Dalexm77/PowerAmp_OM2.7/Board/11882884293.webp

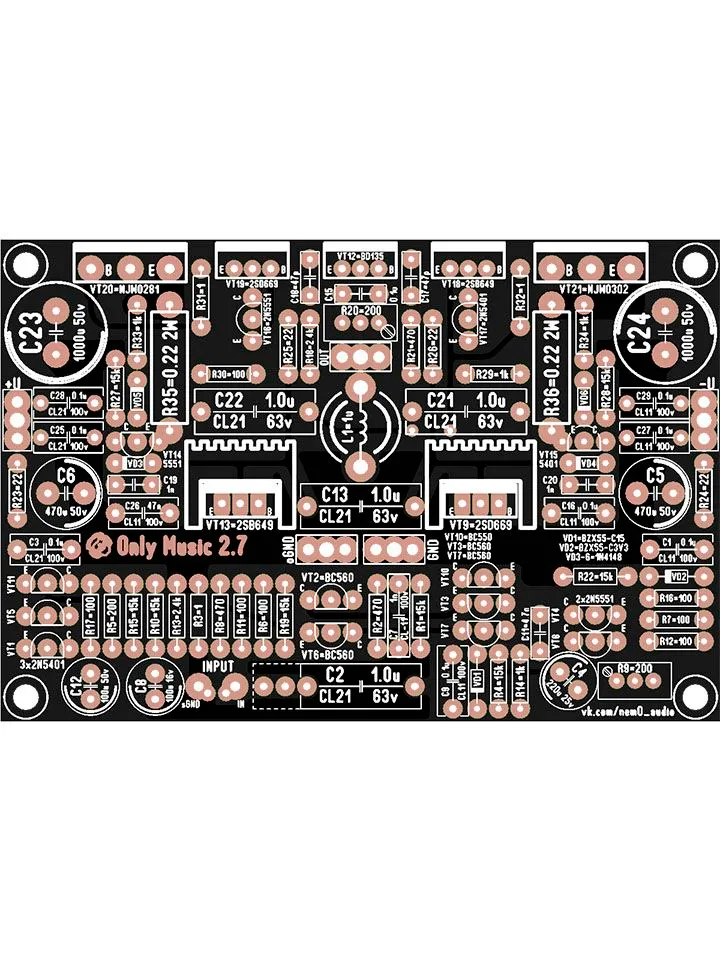
Board/11882884293.webp
