Dalexm77/PowerAmp_OM2.7/README.md

# PowerAmp_OM2.7
Power amplifier based on OM2.7 by Nem0

Элементная база:

Предпочтительно использовать металлопленочные резисторы (MF), и отказаться от использования углеродистых резисторов (CF), по причине их высокого собственного шума;

При использовании резисторов с допуском 5%, желательно осуществить подбор резисторов R6 и R11, R7 и R12, в пары, с точностью не хуже 1%;

Для достижения равного коэффициента усиления и соответственно - равной громкости обоих каналов стерео усилителя, рекомендуется заранее подобрать по две пары резисторов 15 кОм и 470 Ом (для левого и правого каналов усилителя), с точностью не хуже 1%, для использования их в качестве - R1 и R19, R2 и R8;

При использовании резисторов с допуском 1%, осуществлять подбор резистор - нет необходимости;

Использование в качестве R35 и R36 проволочных резисторов - не рекомендуется;

В качестве подстроечных резисторов R9 и R20, допускается использовать только многооборотные резисторы типа 3296W. Допускается использовать подстроечные резисторы с сопротивлением от 200 до 470 Ом;

При установке на плату, движок подстроечного резистора R9 должен находится в среднем положении (сопротивление между каждым из крайних и центральным выводов должно быть одинаковым), а сопротивление подстроечного резистора R20 должно максимальным;

Все типы применяемых в схеме конденсаторов и их минимально необходимое рабочее напряжение указаны в списке радиоэлементов к данной статье;
Типы конденсаторов

Не стоит переплачивать за конденсаторы аудиофильских серий - применение их в схеме усилителя не приведет к каким-либо улучшениям технических характеристик усилителя;

Допускается использование стабилитронов других моделей, но с тем же номинальным напряжением стабилизации и рассеиваемой мощностью;

Допускается использовать только те модели транзисторов, которые указаны в схеме, либо их аналоги указанные в списке радиоэлементов к данной статье;

Перед установкой каждого их транзисторов на плату, необходимо убедиться в их работоспособности, оригинальности и соответствии параметрам, указанным в даташите на данную модель транзистора;

Транзисторы VT18, VT19, VT20, VT21 и VT12, должны быть установлены на общем радиаторе. Очень приблизительно, площадь радиатора, необходимую для эффективного отвода тепла от усилителя, можно выбрать из расчета 10-15 см2 на каждый Ватт выходной мощности усилителя (1000-1500см2 для одного канала усилителя с выходной мощностью 100 Вт);

Транзисторы VT9 и VT13, могут быть установлены на небольшие теплоотводы (для этого предусмотрены места на печатных платах), однако допускается эксплуатация усилителя без установки транзисторов VT9 и VT13 на радиаторы;

Транзисторы VT2 и VT6, VT3 и VT7, VT4 и VT8, необходимо подобрать в пары по коэффициенту усиления с точностью не хуже 1%;

Выводы на печатной плате. 
Наименование и назначение выводов на односторонней и двухсторонней платах - идентичны, поэтому следующая информация актуальна для обоих вариантов печатных плат:

+U - плюс питания;  
-U - минус питания;  
GND - основная силовая земля;  
oGND - выходная земля (минусовая выходная клемма усилителя);  
sGND - сигнальная земля;  
IN - вход сигнала;  
OUT - выход сигнала (плюсовая выходная клемма усилителя).  

Коммутация блоков внутри усилителя. Правильный способ соединения блоков и земель внутри корпуса усилителя:  
Способ коммутации блоков внутри корпуса стерео усилителя
Эксплуатация усилителя без устройства защиты акустической системы (АС) - не безопасна и строго не рекомендуется. Работа усилителя без устройств защиту допускается только для первого запуска и настройки усилителя. В качестве защиты АС для данного усилителя рекомендую использовать устройство защиты - DEF 2017.  

Настройка усилителя.  
После успешного первого включения усилителя, необходимо произвести регулировку "ноля" и тока покоя. Для регулировки "ноля", необходимо:

1. Замкнуть вход усилителя (замкнуть выводы IN и sGND на плате усилителя);
2. Подключить милливольтметр или мультиметр к выходу усилителя (выводы OUT и oGND на плате);
3. Вращая движок подстроечного резистора R9, добиться максимально близкого к нолю значения постоянного напряжения на выходе усилителя (хорошим можно считать результат, когда постоянное напряжение на выходе усилителя не превышает +/-5 мВ).

На следующем этапе настройки, необходимо выставить какое-либо произвольное значение тока покоя, чтобы прогреть усилитель перед финальной регулировкой тока покоя. Для регулировки тока покоя, необходимо:

1. Щупы мультиметра (милливольтметра), необходимо подключить к эмитерам выходных транзисторов (VT20 и VT21), как показано на иллюстрации;
Точки подключения щупов мультиметра (миливольтметра)
2. Вращая движок подстроечного резистора R20, выставить небольшой ток покоя (примерно 40-50 мА, что соответствует показаниям подключенного к выходу милливольтметра 18 - 22 мВ);
3. Оставить усилитель поработать в таком состоянии приблизительно на десять минут.

Регулировать ток покоя без прогрева усилителя - не рекомендуется так как после прогрева усилителя, значение тока покоя изменится относительно выставленного значения на холодном усилителе.

4. Когда усилитель прогреется (температура выходных транзисторов стабилизируется на одном значении и перестанет расти), можно продолжать регулировку тока покоя;

5. Вращая движок R20, выставляем необходимое значение тока покоя.

Рекомендуется выставлять значение тока покоя в диапазоне от 70 до 100 мА (что соответствует показаниям милливольтметра подключенного к выходу усилителя - 30 - 44 мВ). Большее значение тока покоя не окажет значительного положительного влияния на технические характеристики усилителя, а превышение определенного значения тока покоя, наоборот- приведет к ухудшению технических характеристик и значительному снижению КПД усилителя.

Нагрузку к выходу усилителя для регулировки "нуля" и тока покоя, подключать - нет необходимости.
