Dalexm77/PowerAmp_OM2.7/Board/11882883940.webp

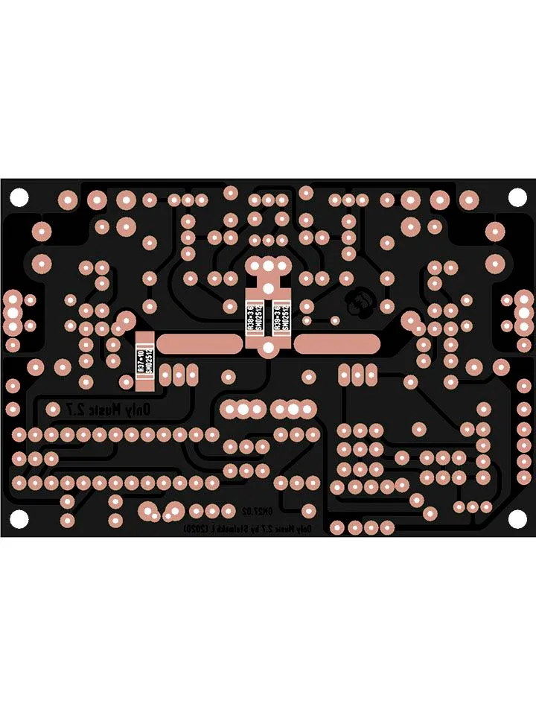
Board/11882883940.webp
