Dalexm77/PowerAmp_OM2.7/Samples/11882883053.webp

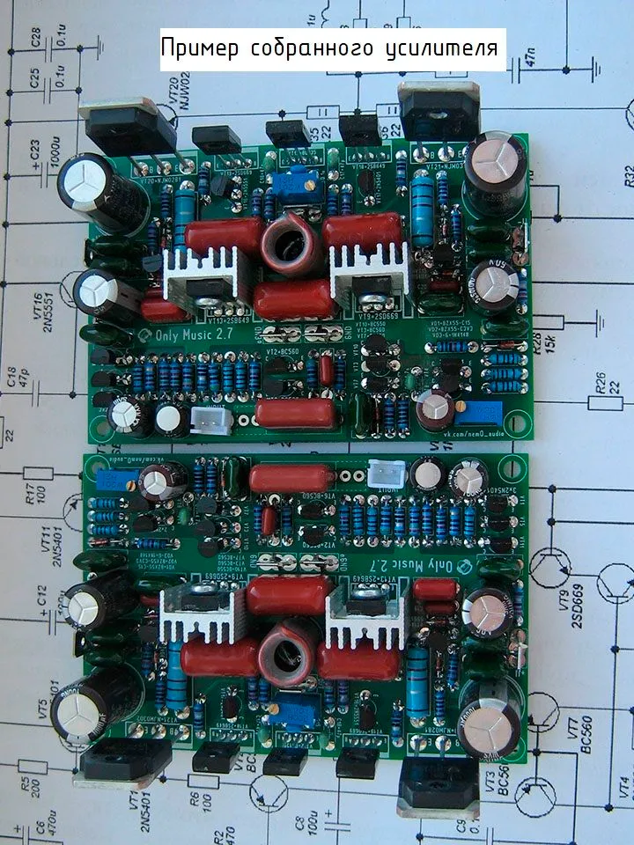
Samples/11882883053.webp
