Dalexm77/PowerAmp_OM2.7/Schema/schemaOM2.7_orig.gif

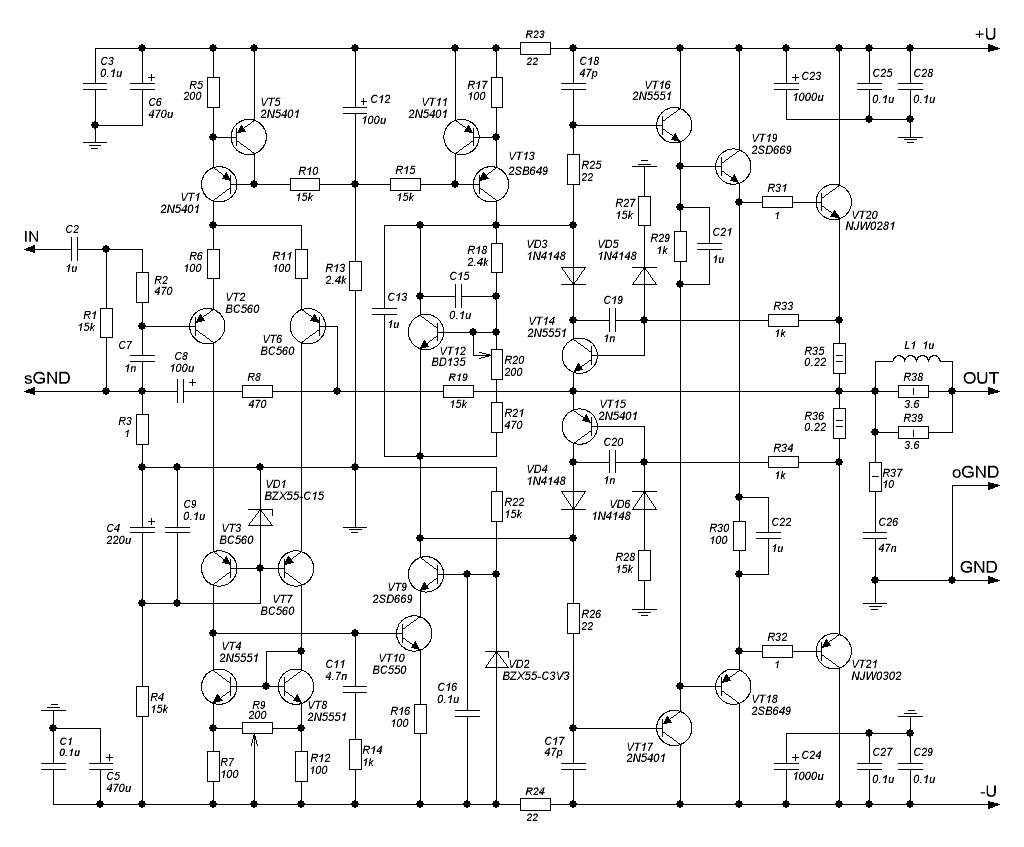
Schema/schemaOM2.7_orig.gif
