Dalexm77/PowerAmp_OM2.7/Schema/Switching blocks inside the amplifier.gif

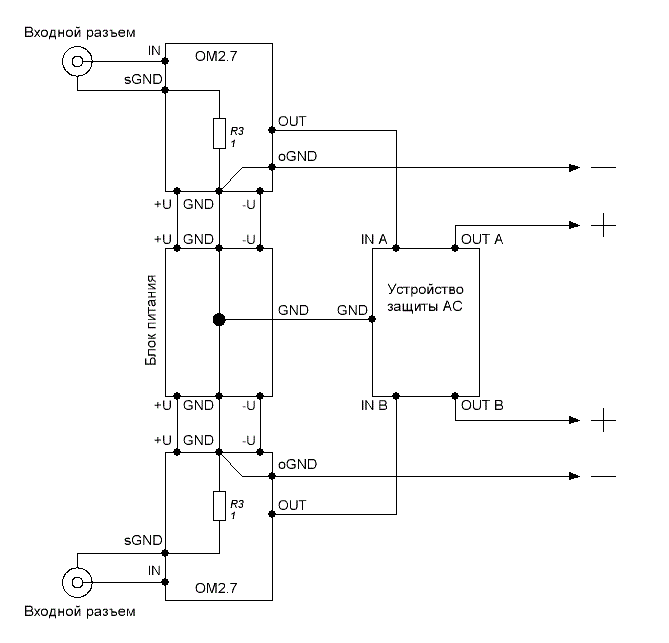
Schema/Switching blocks inside the amplifier.gif
