Dalexm77/PowerAmp_OM2.7/Components/scale_2400 (1).png

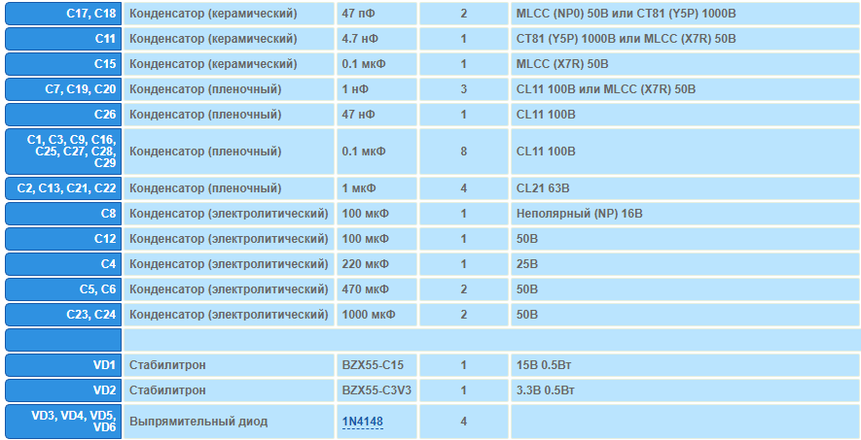
Components/scale_2400 (1).png
