Dalexm77/PowerAmp_OM2.7/(list of files, drawings)

Other design files:
Board/OM27LUT.lay
Tests/OM27.01.ms14
