Dalexm77/PowerAmp_OM2.7/Settings_Tune/AmplifierSettings1.gif

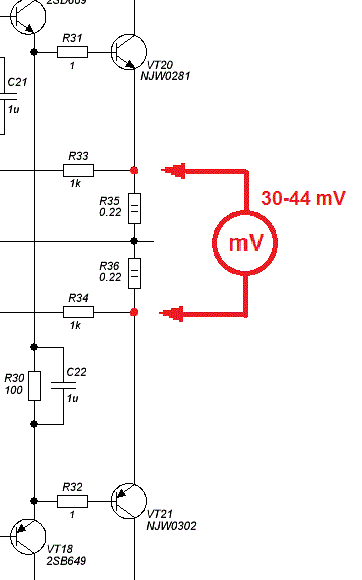
Settings_Tune/AmplifierSettings1.gif
