Dalexm77/PowerAmp_OM2.7/Tests/scale_1200.png

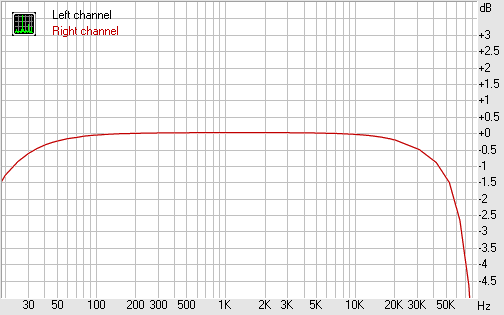
Tests/scale_1200.png
