Dalexm77/PowerAmp_OM2.7/(commit log)

2026-09-06 Amplifier board components
2026-09-06 Board, setting, schema etc.
    [OM27.01.ms14, OM27LUT.lay]
2026-09-06 Ready for assembling
    [OM27.01.ms14, OM27LUT.lay]
